datapeice/yesod/README.md

# Project YESOD 

> **Z80 Bare-Metal Dino Runner on a Real OLED Display**

YESOD is a hardware retro-game project: a tiny **Dinosaur Runner** (inspired by the Chrome offline dino game) running on a real **Zilog Z80** CPU, with an **SSD1306 128×64 OLED** display driven over a **bit-banged I2C** bus, and an **Arduino Nano** acting as a ROM emulator.

No HAL. No libraries. No OS. Just pure Z80 Assembly, raw I/O ports, and precise bit-banging.

Watch on YouTube (https://www.youtube.com/watch?v=rzCK3ROISEs)

---

## Hardware Architecture

| Component | Role |
|---|---|
| **Zilog Z80** | Main CPU — runs the game loop |
| **Arduino Nano (ATmega328P)** | ROM emulator — serves Z80 machine code over the data bus |
| **SSD1306 128×64 OLED** | Display — connected via I2C (bit-banged through Z80 I/O port `0xFF`) |
| **Button** | Jump input — triggers Z80 `INT` (mode 1 interrupt at `0x0038`) |

The schematic below shows the full bus wiring:

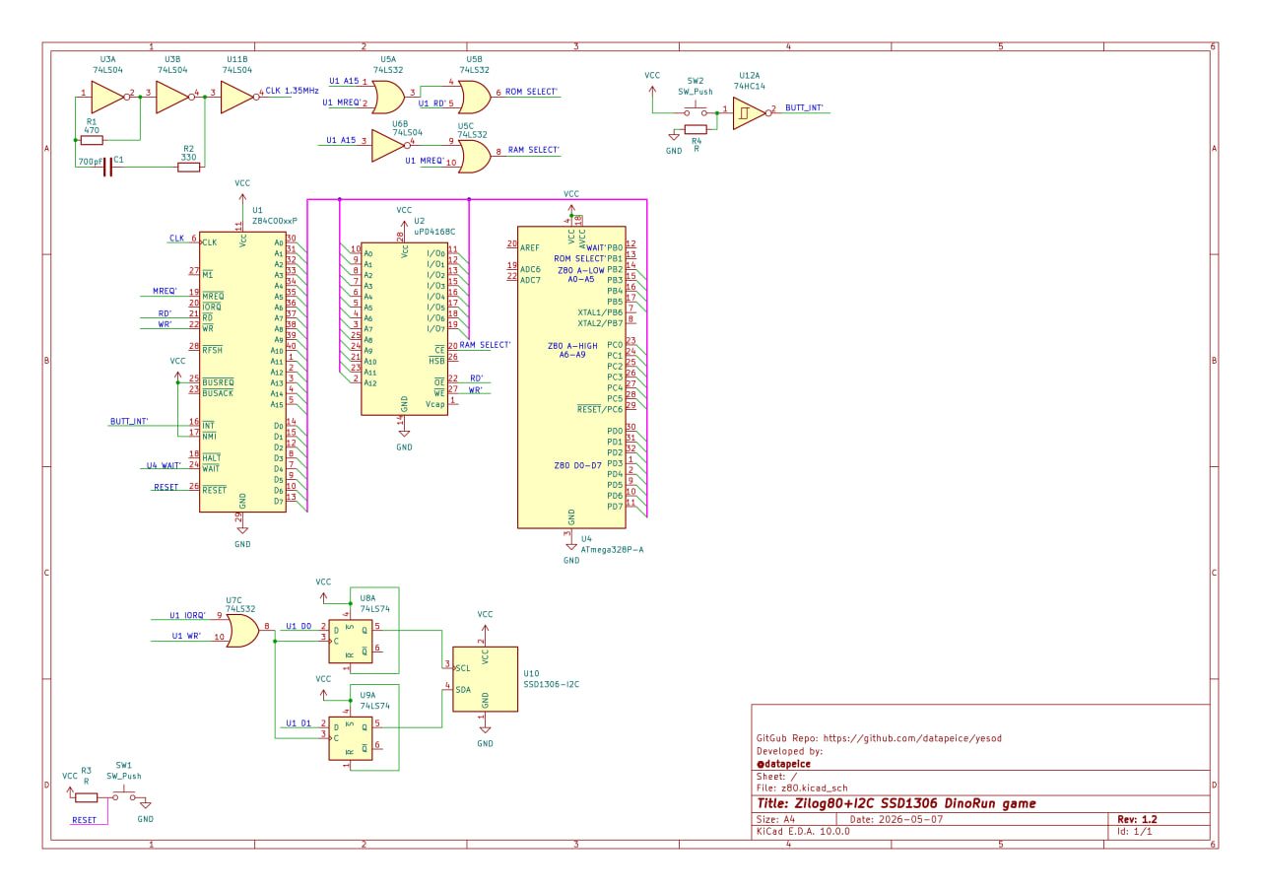
[picture p1: schemat.jpg]
Yesod schematic


### Memory Map

```
0x0000 ┌─────────────────────────────────────────┐
       │                                         │
       │   ROM  (32 KB)                          │
       │   Served by Arduino Nano over data bus  │
       │                                         │
       │   0x0000  _start, I2C routines          │
       │   0x0038  INT handler (jump button)     │
       │   0x004D  _i2c_write                    │
       │   0x006C  _ssd1306_Init                 │
       │   0x008E  _init_seq_data                │
       │   0x009C  _ssd1306_UpdateScreen         │
       │   0x00ED  _init_and_main / game loop    │
       │                                         │
0x7FFF └─────────────────────────────────────────┘
0x8000 ┌─────────────────────────────────────────┐
       │                                         │
       │   RAM  (32 KB)                          │
       │                                         │
       │   0x8000–0x82FF   unused                │
       │                                         │
       │   0x8300–0x83FF   Frame buffer (256 B)  │
       │   ├─ 0x8300–0x837F  Page 6 — jump row  │
       │   │     0x8314 = dino column (air)      │
       │   └─ 0x8380–0x83FF  Page 7 — floor row │
       │         0x8394 = dino column (ground)   │
       │         0x8380+X = cactus position      │
       │                                         │
       │   0x8400   Cactus X position            │
       │   0x8401   Jump flag (1 = jumping)      │
       │   0x8402   Jump timer countdown         │
       │   0x8403   Game-over flag               │
       │                                         │
       │   0x8404–0xFFFF   unused                │
       │                                         │
       │   0xA000           Stack pointer (SP)   │
       │                                         │
0xFFFF └─────────────────────────────────────────┘
```

---

## How the Game Works

The entire game logic lives in [`crt0.s`](crt0.s) — a single Z80 assembly file compiled with **SDCC/SDASZ80**.

### Boot sequence
1. `_start` at `0x0000`: disables interrupts, sets up stack at `0xA000`, enables IM 1 mode, configures I2C lines, and jumps to `_init_and_main`.
2. `_ssd1306_Init`: sends the SSD1306 initialisation sequence over bit-banged I2C.
3. Variables are zeroed, interrupts enabled — game loop starts.

### Game loop (`_game_loop`)
Each frame:
1. **Clear** the frame buffer — 256 bytes at `0x8300–0x83FF` (pages 6–7) filled with zeros.
2. **Draw the floor** — a row of `0x80` bytes at `0x8380`.
3. **Check game-over flag** — if set, draw two `>` symbols ("eyes") and skip to frame send.
4. **Dino logic** — dino is at a fixed column (`0x14` or `0x94` in the floor row). If the jump flag is set, draw it in the air row (`0x8314`) and decrement the jump timer; when timer hits zero, clear the jump flag.
5. **Cactus logic** — draw a `0xFF` byte at the cactus's current X position in the floor row. Move the cactus left by 4 pixels per frame; wrap around at `0`.
6. **Collision detection** — if the cactus X is between 9 and 23 and the dino is NOT jumping → set game-over flag.
7. **Send frame** via `_ssd1306_UpdateScreen` (I2C transfer of the whole frame buffer to the OLED).

### Interrupt handler (`_int_m1` at `0x0038`)
Triggered by the jump button (INT line). Sets the jump flag and loads the jump timer (`10` ticks) if the dino is not already airborne.

### I2C bit-banging (port `0xFF`)
| Port `0xFF` value | Meaning |
|---|---|
| `0x00` | SDA=0, SCL=0 |
| `0x01` | SDA=1, SCL=0 (START condition) |
| `0x02` | SDA=0, SCL=0 → `0x03` SCL=1 (clock pulse) |
| `0x03` | SDA=1, SCL=1 (idle / STOP) |

`_i2c_write` shifts out 8 bits MSB-first with clock pulses; ACK bit is sent but not checked (display assumed always ready).

---

## Repository Structure

```
yesod/
├── crt0.s            # ★ Main game source — full Z80 assembly
├── run.py            # Build script: assembles → compiles → generates z80_rom.h
├── z80_rom.h         # Generated ROM byte array (included in the Arduino sketch)
├── pasmo.exe         # Pasmo Z80 assembler (Windows binary, alternative toolchain)
├── schemat.jpg       # Hardware wiring schematic
└── sketch/
    └── sketch.ino    # Arduino Nano ROM emulator firmware
```

---

## Toolchain

### Requirements
- [SDCC](https://sdcc.sourceforge.net/) — Small Device C Compiler (provides `sdcc` + `sdasz80`)
- [Python 3](https://www.python.org/) — for the build script
- [Arduino IDE](https://www.arduino.cc/) — to flash the Nano

### Build

```bash
python run.py
```

The script does the following:
1. Cleans old intermediate build files (`.rel`, `.ihx`, `.lk`, `.lst`, `.map`, `.noi`, `.sym`).
2. Assembles `crt0.s` with `sdasz80`.
3. Links `crt0.rel` with `sdcc` placing code at `0x0000` and data at `0x8000`.
4. Parses the resulting `main.ihx` (Intel HEX) and extracts ROM bytes (addresses below `0x8000`).
5. Writes the ROM as a C byte array to `z80_rom.h`.

### Flash Arduino

1. Open `sketch/sketch.ino` in the Arduino IDE.
2. Make sure `z80_rom.h` is up to date (run `python run.py` first).
3. Upload to the Arduino Nano — it will serve ROM bytes to the Z80 data bus on every `~RD` pulse.

---

## How the Arduino ROM Emulator Works

[`sketch/sketch.ino`](sketch/sketch.ino) configures the ATmega328P pins as follows:

| Arduino pins | Role |
|---|---|
| `PORTD` (D0–D7) | Z80 Data Bus (bidirectional, output when serving ROM) |
| `PORTC` (A0–A5) | Address bus bits A0–A5 |
| `PORTB` (D8–D11) | Address bus bits A6–A9 |
| `PORTB` bit 1 (D9) | `~RD` signal from Z80 |
| `PORTB` bit 0 (D8) | `~OE` / data-enable output |

On each falling edge of `~RD`, the Nano reads the 10-bit address (A0–A9), looks it up in `z80_rom[]`, and drives the data bus with the corresponding byte. After `~RD` goes high, the data bus is tri-stated.

---

## License

This project is open-source. Feel free to study, modify, and build on it.
