datapeice/yesod/sketch/sketch.ino

#include <avr/io.h>
const uint8_t z80_rom[514] = {
  0xF3, 0x31, 0x00, 0xA0, 0xED, 0x56, 0x3E, 0x03, 0xD3, 0xFF, 0xC3, 0xED, 0x00, 0x3E, 0x01, 0xD3,
  0xFF, 0x3E, 0x00, 0xD3, 0xFF, 0xC9, 0x3E, 0x00, 0xD3, 0xFF, 0x3E, 0x01, 0xD3, 0xFF, 0x3E, 0x03,
  0xD3, 0xFF, 0xC9, 0x00, 0x00, 0x00, 0x00, 0x00, 0x00, 0x00, 0x00, 0x00, 0x00, 0x00, 0x00, 0x00,
  0x00, 0x00, 0x00, 0x00, 0x00, 0x00, 0x00, 0x00, 0xF5, 0x3A, 0x01, 0x84, 0xB7, 0x20, 0x0A, 0x3E,
  0x01, 0x32, 0x01, 0x84, 0x3E, 0x0A, 0x32, 0x02, 0x84, 0xF1, 0xFB, 0xED, 0x4D, 0x06, 0x08, 0xCB,
  0x01, 0x3E, 0x00, 0x30, 0x02, 0x3E, 0x02, 0xD3, 0xFF, 0x3C, 0xD3, 0xFF, 0x3D, 0xD3, 0xFF, 0x10,
  0xEE, 0x3E, 0x02, 0xD3, 0xFF, 0x3C, 0xD3, 0xFF, 0x3D, 0xD3, 0xFF, 0xC9, 0xF3, 0xCD, 0x0D, 0x00,
  0x0E, 0x78, 0xCD, 0x4D, 0x00, 0x0E, 0x00, 0xCD, 0x4D, 0x00, 0x21, 0x8E, 0x00, 0x06, 0x0E, 0x4E,
  0xE5, 0xC5, 0xCD, 0x4D, 0x00, 0xC1, 0xE1, 0x23, 0x10, 0xF5, 0xCD, 0x16, 0x00, 0xC9, 0xAE, 0x20,
  0x00, 0x21, 0x00, 0x7F, 0x22, 0x00, 0x07, 0xA1, 0xC8, 0x8D, 0x14, 0xAF, 0xCD, 0x0D, 0x00, 0x0E,
  0x78, 0xCD, 0x4D, 0x00, 0x0E, 0x00, 0xCD, 0x4D, 0x00, 0x0E, 0x21, 0xCD, 0x4D, 0x00, 0x0E, 0x00,
  0xCD, 0x4D, 0x00, 0x0E, 0x7F, 0xCD, 0x4D, 0x00, 0x0E, 0x22, 0xCD, 0x4D, 0x00, 0x0E, 0x06, 0xCD,
  0x4D, 0x00, 0x0E, 0x07, 0xCD, 0x4D, 0x00, 0xCD, 0x16, 0x00, 0xCD, 0x0D, 0x00, 0x0E, 0x78, 0xCD,
  0x4D, 0x00, 0x0E, 0x40, 0xCD, 0x4D, 0x00, 0x21, 0x00, 0x83, 0x11, 0x00, 0x01, 0x4E, 0xD5, 0xCD,
  0x4D, 0x00, 0xD1, 0x23, 0x1B, 0x7A, 0xB3, 0x20, 0xF4, 0xCD, 0x16, 0x00, 0xC9, 0xCD, 0x6C, 0x00,
  0x3E, 0x78, 0x32, 0x00, 0x84, 0xAF, 0x32, 0x01, 0x84, 0x32, 0x02, 0x84, 0x32, 0x03, 0x84, 0xFB,
  0x21, 0x00, 0x80, 0x01, 0x00, 0x04, 0x36, 0x00, 0x23, 0x0B, 0x78, 0xB1, 0x20, 0xF8, 0x21, 0x80,
  0x83, 0x06, 0x80, 0x36, 0x80, 0x23, 0x10, 0xFB, 0x3A, 0x03, 0x84, 0xB7, 0x28, 0x13, 0x21, 0xB0,
  0x80, 0x36, 0x3E, 0x23, 0x23, 0x23, 0x21, 0xD0, 0x80, 0x36, 0x3E, 0x23, 0x23, 0x23, 0xC3, 0x80,
  0x01, 0x3A, 0x01, 0x84, 0xB7, 0x20, 0x07, 0x21, 0x94, 0x83, 0x36, 0xFF, 0x18, 0x12, 0x21, 0x14,
  0x83, 0x36, 0xFF, 0x3A, 0x02, 0x84, 0x3D, 0x32, 0x02, 0x84, 0x20, 0x04, 0xAF, 0x32, 0x01, 0x84,
  0x3A, 0x00, 0x84, 0x6F, 0x26, 0x00, 0x11, 0x80, 0x83, 0x19, 0x36, 0xFF, 0x3A, 0x00, 0x84, 0xD6,
  0x04, 0xFE, 0x79, 0x38, 0x02, 0x3E, 0x78, 0x32, 0x00, 0x84, 0x3A, 0x00, 0x84, 0xFE, 0x18, 0x30,
  0x0F, 0xFE, 0x09, 0x38, 0x0B, 0x3A, 0x01, 0x84, 0xB7, 0x20, 0x05, 0x3E, 0x01, 0x32, 0x03, 0x84,
  0xCD, 0x9C, 0x00, 0xC3, 0x00, 0x01, 0x00, 0x00, 0x00, 0x00, 0x00, 0x00, 0x00, 0x00, 0x00, 0x00,
  0x00, 0x00, 0x00, 0x00, 0x00, 0x00, 0x00, 0x00, 0x00, 0x00, 0x00, 0x00, 0x00, 0x00, 0x00, 0x00,
  0x00, 0x00, 0x00, 0x00, 0x00, 0x00, 0x00, 0x00, 0x00, 0x00, 0x00, 0x00, 0x00, 0x00, 0x00, 0x00,
  0x00, 0x00, 0x00, 0x00, 0x00, 0x00, 0x00, 0x00, 0x00, 0x00, 0x00, 0x00, 0x00, 0x00, 0x00, 0x00,
  0x00, 0x00, 0x00, 0x00, 0x00, 0x00, 0x00, 0x00, 0x00, 0x00, 0x00, 0x00, 0x00, 0x00, 0x00, 0x00,
  0x00, 0x00, 0x00, 0x00, 0x00, 0x00, 0x00, 0x00, 0x00, 0x00, 0x00, 0x00, 0x00, 0x00, 0x00, 0x00,
  0x00, 0x00, 0x00, 0x00, 0x00, 0x00, 0x00, 0x00, 0x00, 0x00, 0x00, 0x00, 0x00, 0x00, 0x00, 0x00,
  0x00, 0x00, 0x00, 0x00, 0x00, 0x00, 0x00, 0x00, 0x00, 0x00, 0x00, 0x00, 0x00, 0x00, 0x00, 0x00,
  0xC9, 0xFE,
};




int main() {
  DDRD   = 0x00;
  DDRC  &= ~0x3F;
  DDRB  |=  0x01;
  DDRB  &= ~0x3E;
  PORTB |=  0x01; 

while (1) {
    if (!(PINB & 0x02)) {
      PORTB &= ~0x01;  

      uint16_t addr = (PINC & 0x3F) | ((PINB & 0x3C) << 4);
      PORTD = (addr < sizeof(z80_rom)) ? z80_rom[addr] : 0x00;
      DDRD  = 0xFF;

      PORTB |= 0x01; 

      while (!(PINB & 0x02));

      DDRD  = 0x00;
    }
  }
}
